aaromalonline/ictester/sim/socket_lcd.jpeg

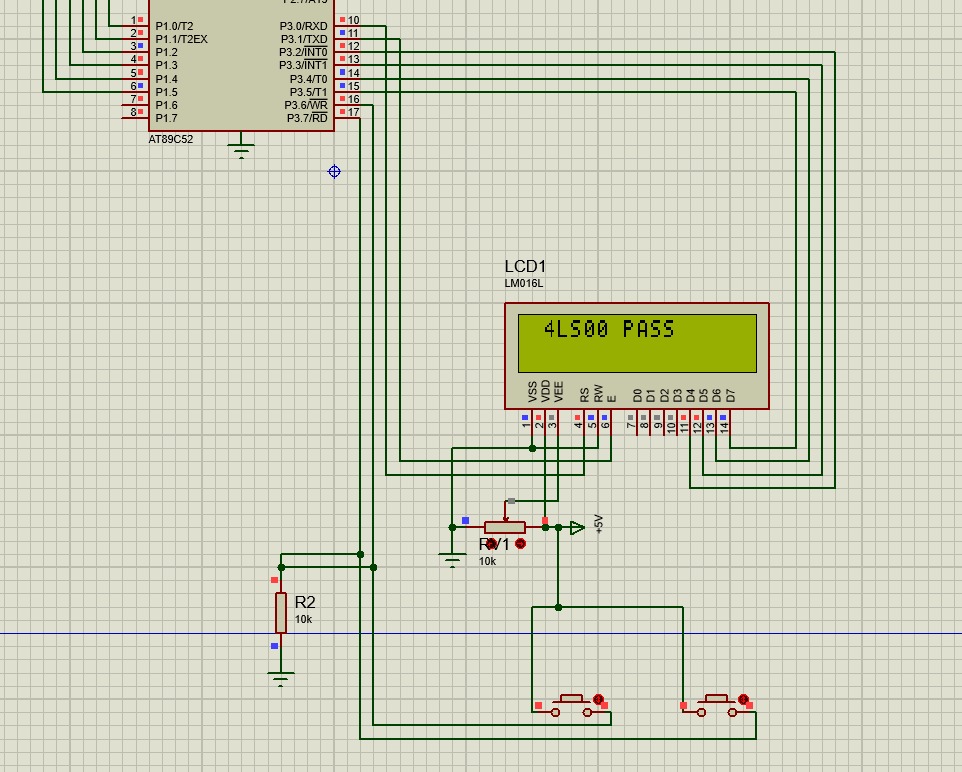
sim/socket_lcd.jpeg
