aaromalonline/ictester/(list of files, drawings)

Other design files:
sim/ictester_withoutsocket.pdsprj
sim/ictester_withsocket.pdsprj
