aaromalonline/ictester/(commit log)

2026-09-28 added sim files
    [ictester_withoutsocket.pdsprj, ictester_withsocket.pdsprj]
2026-09-28 arduino uno as isp sketch and hex flashing py script added
2026-10-30 Updated readme with description, components, circuit and connections, usage
    Expanded README to include detailed description, components list, circuit connections, programming instructions, and usage guidelines for the 8051 IC Tester.
2026-10-30 public/ added with flowchart, block diagram, demos and linked in README
